LIV2/A4092-dev/README.md

# A4092

A modern successor to the A4091.

* TSSOP parts for smaller footprint
* Flash instead of EPROM
* CPLD instead of GALs
* Autoconfig moved into CPLD

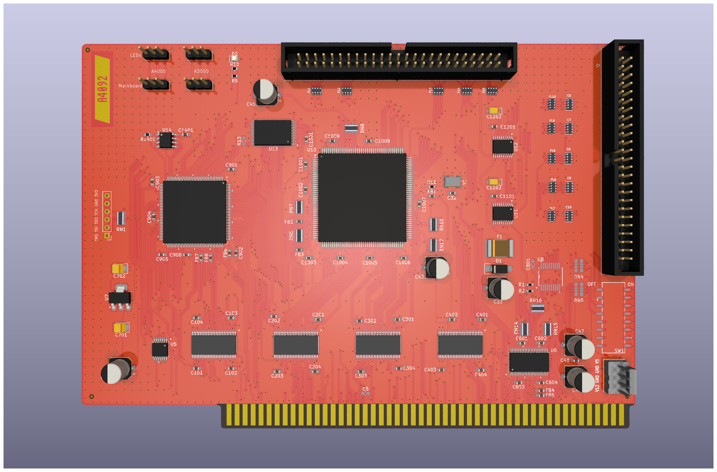
[picture p1: Docs/PCB.png]
PCB
