LIV2/A4092-dev/GALs/README.md

This is the old GAL based implementation of the A4091 glue logic for reference
