LIV2/A4092-dev/Kicad/Terminator-DS21S07/A4092-terminator-ds2107.kicad_pcb

## KiCad design Kicad/Terminator-DS21S07/A4092-terminator-ds2107.kicad_pcb (2025-06-09)

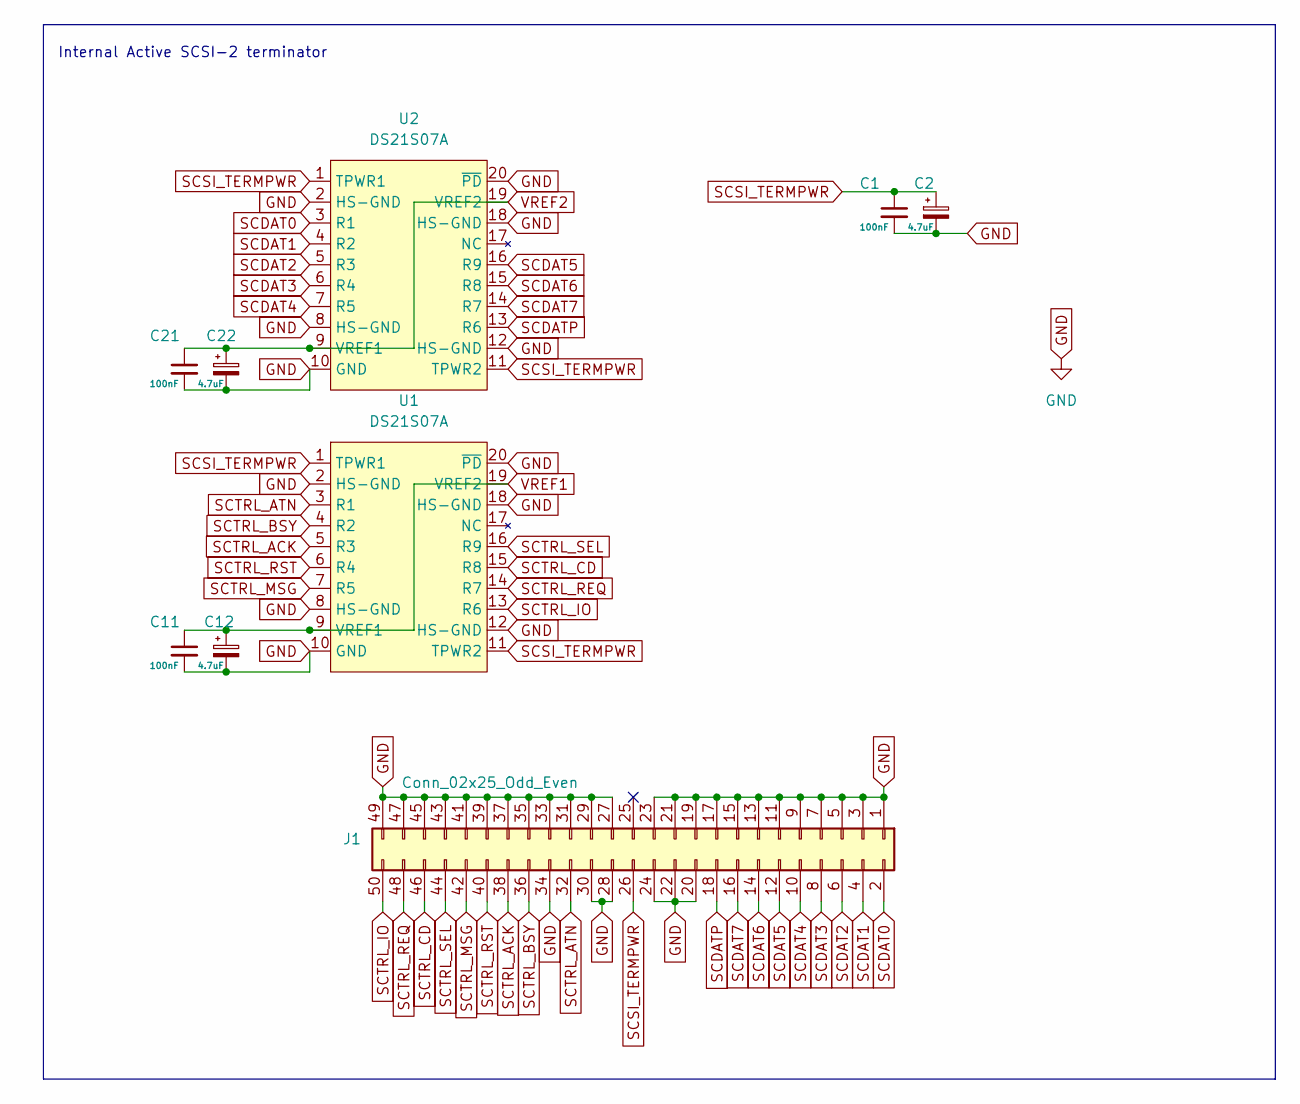
[picture p2: schematic A4092-terminator-ds2107.kicad_sch, A4092 backpanel PCB]

Parts:
C1, C11, C21: 100nF; C_0603_1608Metric_Pad1.08x0.95mm_HandSolder; LCSC Part # C14663
C2, C12, C22: 4.7uF; CP_EIA-3216-10_Kemet-I_HandSolder; LCSC Part # C7189
J1: Conn_02x25_Odd_Even; IDC-Header_2x25_P2.54mm_Horizontal; LCSC Part # C7430330
U1, U2: DS21S07A; TSSOP-20_4.4x6.5mm_P0.65mm; LCSC Part # C6602097

Connections:
GND: C1.2, C2.2, C11.2, C12.2, C21.2, C22.2, J1.1, J1.3, J1.5, J1.7, J1.9, J1.11, J1.13, J1.15, J1.17, J1.19, J1.20, J1.21, J1.22, J1.23, J1.24, J1.27, J1.28, J1.29, J1.30, J1.31, J1.33, J1.34, J1.35, J1.37, J1.39, J1.41, J1.43, J1.45, J1.47, J1.49, U1.2 (HS-GND), U1.8 (HS-GND), U1.10 (GND), U1.12 (HS-GND), U1.18 (HS-GND), U1.20 (~PD), U2.2 (HS-GND), U2.8 (HS-GND), U2.10 (GND), U2.12 (HS-GND), U2.18 (HS-GND), U2.20 (~PD)
SCDAT0: J1.2, U2.3 (R1)
SCDAT1: J1.4, U2.4 (R2)
SCDAT2: J1.6, U2.5 (R3)
SCDAT3: J1.8, U2.6 (R4)
SCDAT4: J1.10, U2.7 (R5)
SCDAT5: J1.12, U2.16 (R9)
SCDAT6: J1.14, U2.15 (R8)
SCDAT7: J1.16, U2.14 (R7)
SCDATP: J1.18, U2.13 (R6)
SCSI_TERMPWR: C1.1, C2.1, J1.26, U1.1 (TPWR1), U1.11 (TPWR2), U2.1 (TPWR1), U2.11 (TPWR2)
SCTRL_ACK: J1.38, U1.5 (R3)
SCTRL_ATN: J1.32, U1.3 (R1)
SCTRL_BSY: J1.36, U1.4 (R2)
SCTRL_CD: J1.46, U1.15 (R8)
SCTRL_IO: J1.50, U1.13 (R6)
SCTRL_MSG: J1.42, U1.7 (R5)
SCTRL_REQ: J1.48, U1.14 (R7)
SCTRL_RST: J1.40, U1.6 (R4)
SCTRL_SEL: J1.44, U1.16 (R9)
VREF1: C11.1, C12.1, U1.9 (VREF1), U1.19 (VREF2)
VREF2: C21.1, C22.1, U2.9 (VREF1), U2.19 (VREF2)

Notes on the sheet:
Internal Active SCSI-2 terminator

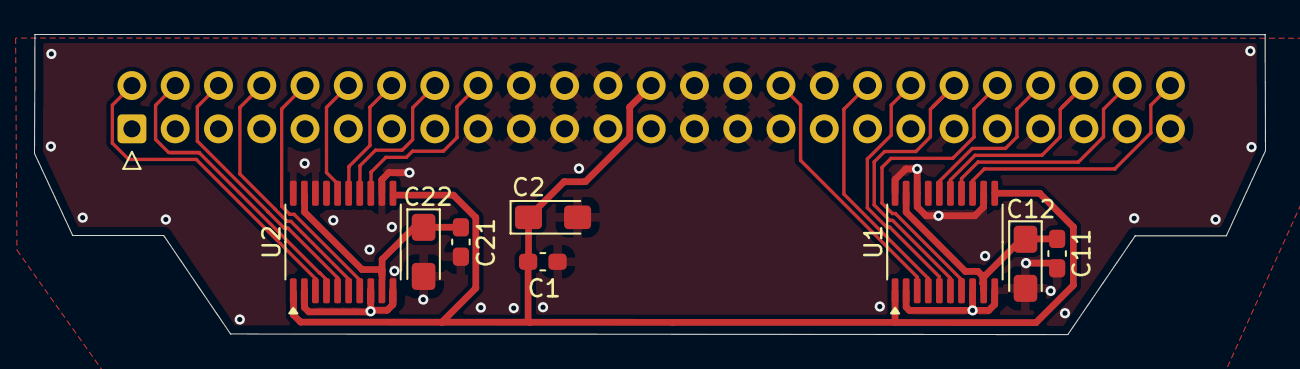
[picture p3: board A4092-terminator-ds2107.kicad_pcb from above]

Board: 2 copper layers, 72.3 x 17.6 mm, 9 parts (0 on the bottom side), 22 nets.
