LIV2/A4092-dev/Kicad/Terminator-dev/A4092-terminator-dev.kicad_pcb

## KiCad design Kicad/Terminator-dev/A4092-terminator-dev.kicad_pcb (2025-06-09)

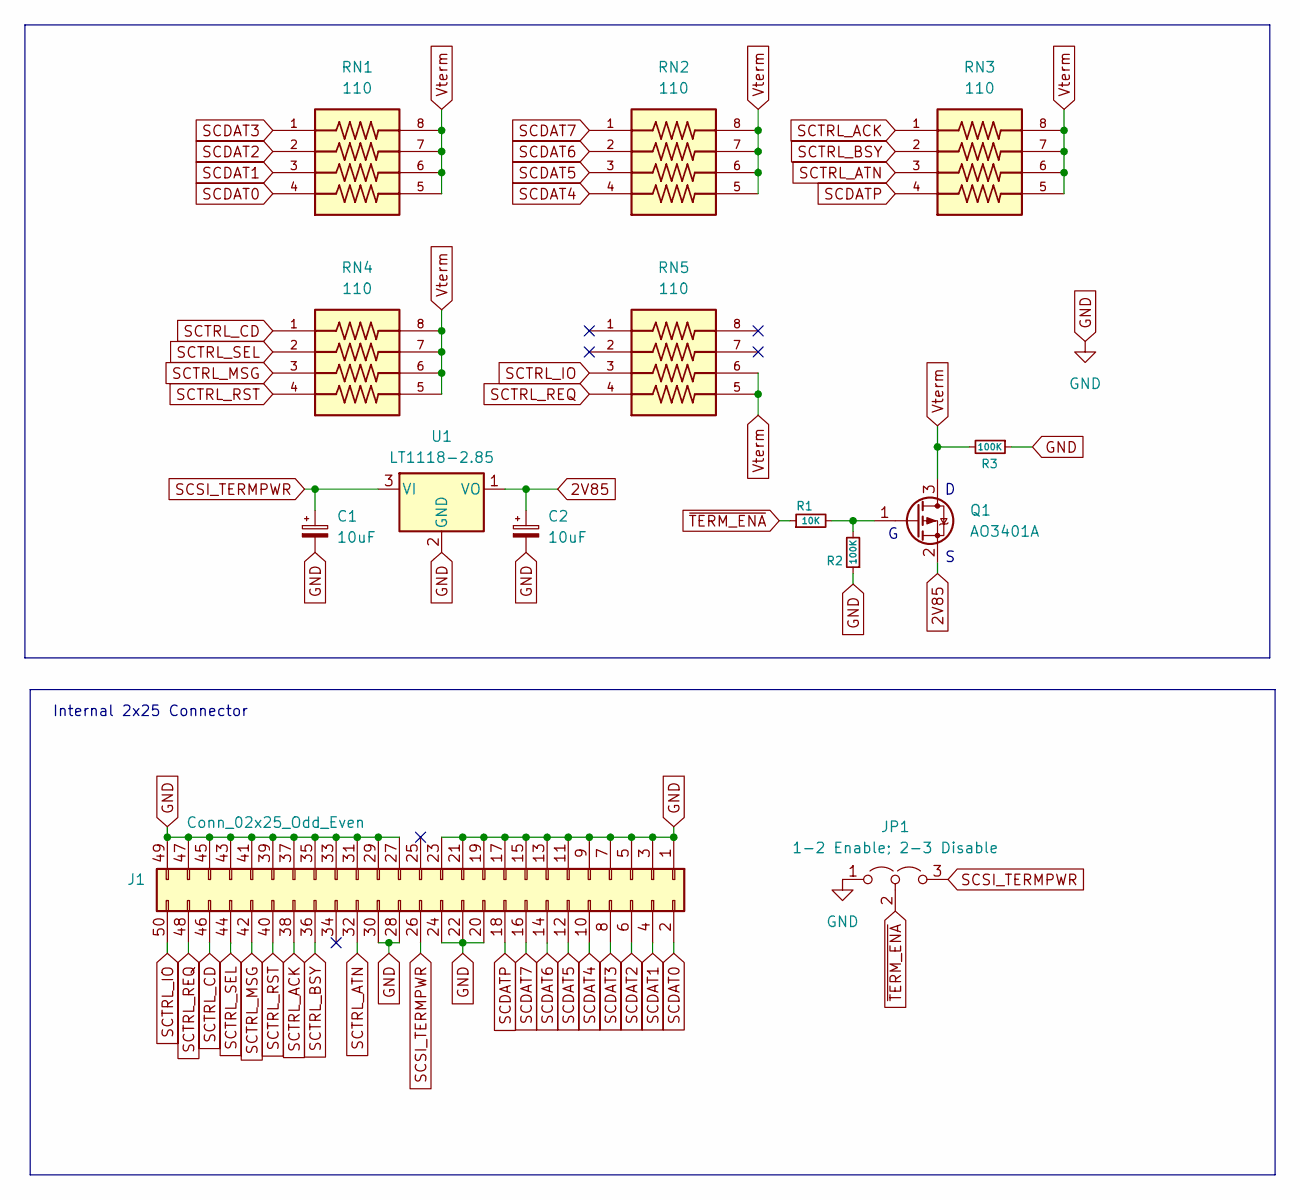
[picture p4: schematic A4092-terminator-dev.kicad_sch, A4092 backpanel PCB]

Parts:
C1, C2: 10uF; CP_EIA-2012-12_Kemet-R; LCSC Part # C7171
J1: Conn_02x25_Odd_Even; IDC-Header_2x25_P2.54mm_Horizontal; LCSC Part # C7430330
JP1: 1-2 Enable; 2-3 Disable; PinHeader_1x03_P2.00mm_Horizontal
Q1: AO3401A; SOT-23
R1: 10K; R_0603_1608Metric
R2, R3: 100K; R_0603_1608Metric
RN1, RN2, RN3, RN4, RN5: 110; BO_CAY16; PARTREV V.9; LCSC Part # C176176
U1: LT1118-2.85; SOT-223-3_TabPin2; LCSC Part # C2870974

Connections:
2V85: C2.1, Q1.2 (S), U1.1 (VO)
GND: C1.2, C2.2, J1.1, J1.3, J1.5, J1.7, J1.9, J1.11, J1.13, J1.15, J1.17, J1.19, J1.20, J1.21, J1.22, J1.23, J1.24, J1.27, J1.28, J1.29, J1.30, J1.31, J1.33, J1.35, J1.37, J1.39, J1.41, J1.43, J1.45, J1.47, J1.49, JP1.1 (A), R2.1, R3.1, U1.2 (GND)
unnamed: Q1.1 (G), R1.2, R2.2
SCDAT0: J1.2, RN1.4
SCDAT1: J1.4, RN1.3
SCDAT2: J1.6, RN1.2
SCDAT3: J1.8, RN1.1
SCDAT4: J1.10, RN2.4
SCDAT5: J1.12, RN2.3
SCDAT6: J1.14, RN2.2
SCDAT7: J1.16, RN2.1
SCDATP: J1.18, RN3.4
SCSI_TERMPWR: C1.1, J1.26, JP1.3 (B), U1.3 (VI)
SCTRL_ACK: J1.38, RN3.1
SCTRL_ATN: J1.32, RN3.3
SCTRL_BSY: J1.36, RN3.2
SCTRL_CD: J1.46, RN4.1
SCTRL_IO: J1.50, RN5.3
SCTRL_MSG: J1.42, RN4.3
SCTRL_REQ: J1.48, RN5.4
SCTRL_RST: J1.40, RN4.4
SCTRL_SEL: J1.44, RN4.2
Vterm: Q1.3 (D), R3.2, RN1.5, RN1.6, RN1.7, RN1.8, RN2.5, RN2.6, RN2.7, RN2.8, RN3.5, RN3.6, RN3.7, RN3.8, RN4.5, RN4.6, RN4.7, RN4.8, RN5.5, RN5.6
~TERM_ENA: JP1.2 (C), R1.1

Notes on the sheet:
Internal 2x25 Connector

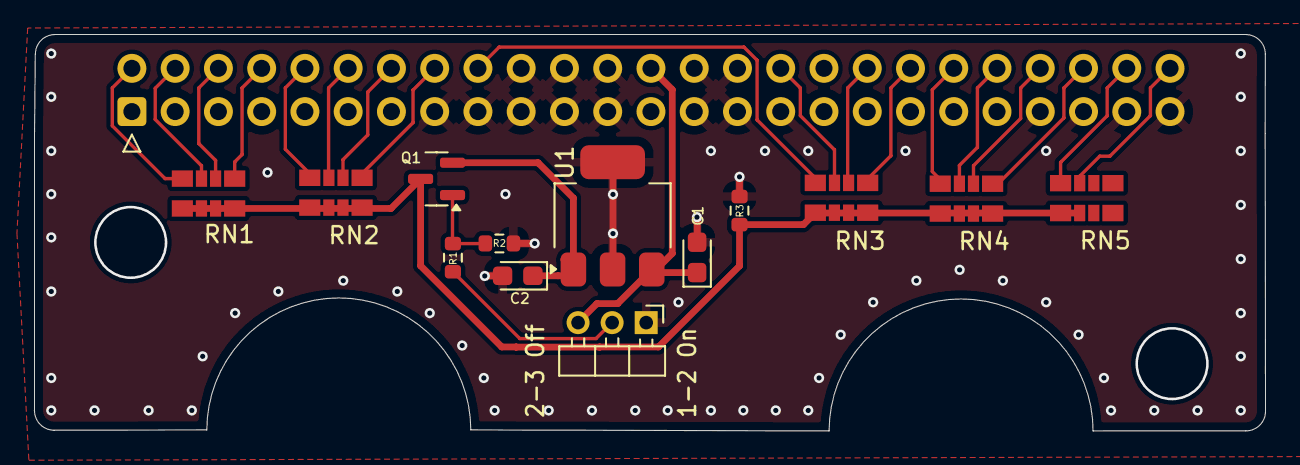
[picture p5: board A4092-terminator-dev.kicad_pcb from above]

Board: 2 copper layers, 72.3 x 23.3 mm, 14 parts (0 on the bottom side), 24 nets.
