LIV2/A4092-dev/Kicad/A4092.kicad_pcb

## KiCad design Kicad/A4092.kicad_pcb (2025-05-24)

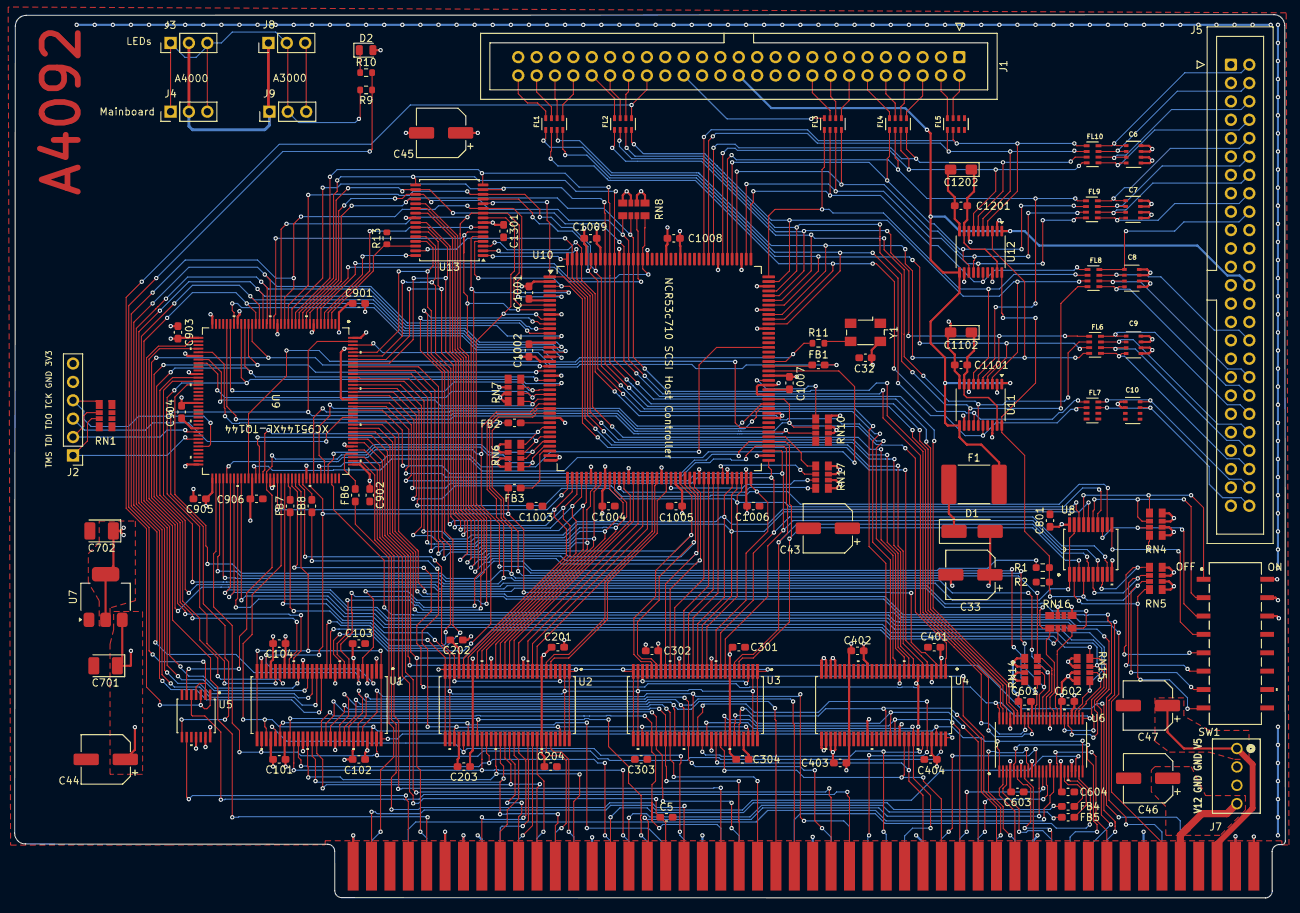
[picture p6: board A4092.kicad_pcb from above]

Board: 4 copper layers, 175.6 x 122.1 mm, 118 parts (0 on the bottom side), 260 nets.

Parts:
C5: 10pF; C_0603_1608Metric_Pad1.08x0.95mm_HandSolder
C6, C7, C8, C9, C10: 100pF; CAP_CA0612_3P2X1P6_YAG
C32, C1002, C1004, C1006, C1008: 10nF; C_0603_1608Metric_Pad1.08x0.95mm_HandSolder
C33, C43, C44, C45, C46, C47: 47uF; CP_Elec_6.3x7.7
C101, C102, C103, C104, C201, C202, C203, C204, C301, C302, C303, C304, C401, C402, C403, C404, C601, C602, C603, C604, C801, C901, C902, C903, C904, C905, C906, C1001, C1003, C1005, C1007, C1009, C1101, C1201, C1301: 100nF; C_0603_1608Metric_Pad1.08x0.95mm_HandSolder
C701: 10uF; CP_EIA-3528-15_AVX-H_HandSolder
C702: 22uF; CP_EIA-3528-15_AVX-H_HandSolder
C1102, C1202: 4.7uF; CP_EIA-3216-10_Kemet-I_HandSolder
CN1: Zorro3; Zorro3-CardEdge
D1: SS24; D_SMA_Handsoldering
D2: LED (green); LED_0805_2012Metric
F1: ASMDC185F/33-2; Fuse_2920_7451Metric_Pad2.10x5.45mm_HandSolder
FB1, FB2, FB3, FB4, FB5, FB6, FB7, FB8: 60; C_0603_1608Metric_Pad1.08x0.95mm_HandSolder
FL1, FL2, FL3, FL4, FL5, FL6, FL7, FL8, FL9, FL10: DA1206D600R-10; FB_DA1206D600R-10
J1, J5: Conn_02x25_Odd_Even; IDC-Header_2x25_P2.54mm_Vertical
J2: Conn_01x06_Pin; PinHeader_1x06_P2.54mm_Vertical
J3: TO-LED; PinHeader_1x03_P2.54mm_Vertical
J4: TO-MB; PinHeader_1x03_P2.54mm_Vertical
J7: 22112042; CONN_A-6373-04A_MOL
J8: TO-A3000-LED; PinHeader_1x03_P2.54mm_Vertical
J9: TO-A3000-MB; PinHeader_1x03_P2.54mm_Vertical
R1: 0; R_0603_1608Metric_Pad0.98x0.95mm_HandSolder
R2: 4K7; R_0603_1608Metric_Pad0.98x0.95mm_HandSolder
R9, R11: 120; R_0603_1608Metric
R10: 2.2k; R_0603_1608Metric
R13: 1K; R_0603_1608Metric
RN1: 4.7K; BO_CAY16
RN4, RN5, RN6, RN7, RN8, RN10, RN14, RN15, RN16, RN17: 1K; BO_CAY16
SW1: 219-8MST; SO16_219-8_CTS
U1, U2, U3, U4: SN74ABT16543DGGR; DL56
U5: 74LVC07APW_118; TSSOP14_5P1X4P5_NEX
U6: SN74ABT16245ADGGR; DGG48
U7: AMS1117-3.3; SOT-223-3_TabPin2
U8: SN74F244DB; DB20
U9: XC95144XL-TQ144; 144-TQFP_XIL
U10: NCR53c710 SCSI Host Controller; PQFP-160_28x28mm_P0.65mm
U11, U12: DS21S07A; TSSOP-20_4.4x6.5mm_P0.65mm
U13: SST39SF010/020/040; TSSOP-32_8x11mm_P0.65mm
Y1: Abracon ACO-50MHz; Oscillator_SMD_Fox_FT5H_5.0x3.2mm

Connections:
A0: RN8.4, U9.6 (I/O/GTS2), U10.144 (A0)
A1: RN8.3, U9.7, U10.145 (A1)
A2: RN8.2, U6.40 (1A6), U9.9, U10.146 (A2), U13.20 (A0)
A3: RN8.1, U6.41 (1A5), U9.10, U10.147 (A3), U13.19 (A1)
A4: U6.43 (1A4), U9.11, U10.148 (A4), U13.18 (A2)
A5: U6.44 (1A3), U9.12, U10.150 (A5), U13.17 (A3)
A6: U6.46 (1A2), U9.13, U10.151 (A6), U13.16 (A4)
A7: U6.47 (1A1), U9.14, U10.152 (A7), U13.15 (A5)
A8: U4.14 (1A8), U9.15, U10.154 (A8), U13.14 (A6)
A9: U4.13 (1A7), U10.155 (A9), U13.13 (A7)
A10: U4.12 (1A6), U10.157 (A10), U13.3 (A8)
A11: U4.10 (1A5), U10.158 (A11), U13.2 (A9)
A12: U4.9 (1A4), U10.159 (A12), U13.31 (A10)
A13: U4.8 (1A3), U10.160 (A13), U13.1 (A11)
A14: U4.6 (1A2), U10.1 (A14), U13.12 (A12)
A15: U4.5 (1A1), U10.3 (A15), U13.4 (A13)
A16: U1.5 (1A1), U10.4 (A16), U13.5 (A14)
A17: U1.6 (1A2), U9.16, U10.5 (A17), U13.11 (A15)
A18: U1.8 (1A3), U9.17, U10.7 (A18), U13.10 (A16)
A19: U1.9 (1A4), U9.19, U10.8 (A19), U13.6 (NC/A17)
A20: U1.10 (1A5), U10.10 (A20), U13.9 (NC/A18)
A21: U1.12 (1A6), U10.11 (A21)
A22: U1.13 (1A7), U10.12 (A22)
A23: U1.14 (1A8), U9.20, U10.13 (A23)
A24: U1.15 (2A1), U9.21, U10.14 (A24)
A25: U1.16 (2A2), U9.22, U10.16 (A25)
A26: U1.17 (2A3), U9.23, U10.17 (A26)
A27: U1.19 (2A4), U9.24, U10.18 (A27)
A28: U1.20 (2A5), U9.25, U10.20 (A28)
A29: U1.21 (2A6), U9.26, U10.21 (A29)
A30: U1.23 (2A7), U9.27, U10.23 (A30)
A31: U1.24 (2A8), U9.28, U10.24 (A31)
ABOEH: U1.1 (*1OEAB), U1.28 (*2OEAB), U1.29 (*2OEBA), U1.56 (*1OEBA), U4.56 (*1OEBA), U9.96
ABOEL: U6.25 (*2OE), U6.48 (*1OE), U9.95
BERR: RN6.1, U5.6 (3Y), U9.88, U10.37 (~BERR/~TEA)
BGACK: RN10.1, U10.98 (~BGACK/~BB)
BMASTER: U1.31 (*2CEBA), U1.54 (*1CEBA), U4.54 (*1CEBA), U6.1 (1DIR), U6.24 (2DIR), U9.92
CBACK: RN6.3, U9.86, U10.35 (~CBACK/~TBI)
CBREQ: RN6.4, U9.87, U10.33 (~CBREQ/~TT1)
CLK: U9.91, U10.41 (BCLK)
CLK_50M: R11.2, U9.30 (I/O/GCK1), U10.102 (SCLK)
D0: U3.5 (1A1), U8.3 (2Y4), U9.124, U10.85 (D0)
D1: U3.6 (1A2), U8.5 (2Y3), U9.125, U10.84 (D1)
D2: U3.8 (1A3), U8.7 (2Y2), U9.126, U10.83 (D2)
D2Z: U2.3 (*1CEAB), U2.26 (*2CEAB), U3.3 (*1CEAB), U3.26 (*2CEAB), U9.97
D3: U3.9 (1A4), U8.9 (2Y1), U9.128, U10.81 (D3)
D4: U3.10 (1A5), U8.12 (1Y4), U9.129, U10.80 (D4)
D5: U3.12 (1A6), U8.14 (1Y3), U9.130, U10.78 (D5)
D6: U3.13 (1A7), U8.16 (1Y2), U9.131, U10.77 (D6)
D7: U3.14 (1A8), U8.18 (1Y1), U9.132, U10.76 (D7)
D8: U3.15 (2A1), U10.73 (D8)
D9: U3.16 (2A2), U10.72 (D9)
D10: U3.17 (2A3), U10.71 (D10)
D11: U3.19 (2A4), U10.70 (D11)
D12: U3.20 (2A5), U10.68 (D12), U13.21 (D0)
D13: U3.21 (2A6), U10.67 (D13), U13.22 (D1)
D14: U3.23 (2A7), U10.66 (D14), U13.23 (D2)
D15: U3.24 (2A8), U10.65 (D15), U13.25 (D3)
D16: U2.5 (1A1), U10.62 (D16)
D17: U2.6 (1A2), U10.60 (D17)
D18: U2.8 (1A3), U10.59 (D18)
D19: U2.9 (1A4), U10.58 (D19)
D20: U2.10 (1A5), U10.57 (D20)
D21: U2.12 (1A6), U10.56 (D21)
D22: U2.13 (1A7), U10.55 (D22)
D23: U2.14 (1A8), U10.53 (D23)
D24: U2.15 (2A1), U9.133, U10.51 (D24)
D25: U2.16 (2A2), U9.134, U10.50 (D25)
D26: U2.17 (2A3), U9.135, U10.48 (D26)
D27: U2.19 (2A4), U9.136, U10.47 (D27)
D28: U2.20 (2A5), U9.137, U10.45 (D28), U13.26 (D4)
D29: U2.21 (2A6), U9.138, U10.44 (D29), U13.27 (D5)
D30: U2.23 (2A7), U9.139, U10.43 (D30), U13.28 (D6)
D31: U2.24 (2A8), U9.140, U10.42 (D31), U13.29 (D7)
DBLT: U2.2 (*1LEAB), U2.27 (*2LEAB), U2.30 (*2LEBA), U2.55 (*1LEBA), U3.2 (*1LEAB), U3.27 (*2LEAB), U3.30 (*2LEBA), U3.55 (*1LEBA), U9.93
DBOE: FB7.1, U2.1 (*1OEAB), U2.28 (*2OEAB), U2.29 (*2OEBA), U2.56 (*1OEBA), U3.1 (*1OEAB), U3.28 (*2OEAB), U3.29 (*2OEBA), U3.56 (*1OEBA)
DIP_EXT_TERM: R1.1, R2.1, RN5.3, SW1.7, U8.4 (1A2), U11.20 (~PD), U12.20 (~PD)
DIP_LONG_SPINUP: RN5.1, SW1.5, U8.8 (1A4)
DIP_SCSI_ADDR0: RN4.1, SW1.1, U8.17 (2A4)
DIP_SCSI_ADDR1: RN4.2, SW1.2, U8.15 (2A3)
DIP_SCSI_ADDR2: RN4.3, SW1.3, U8.13 (2A2)
DIP_SCSI_FAST: RN4.4, SW1.4, U8.11 (2A1)
DIP_SCSI_LUNS: RN5.4, SW1.8, U8.2 (1A1)
DIP_SYNCH_MODE: RN5.2, SW1.6, U8.6 (1A3)
DP0: RN17.1, U10.86 (DP0)
DP1: RN17.2, U10.74 (DP1)
DP2: RN17.3, U10.63 (DP2)
DP3_ABRT: RN17.4, U10.52 (DP3/~ABRT)
GND: C5.2, C6.5, C6.6, C6.7, C6.8, C7.5, C7.6, C7.7, C7.8, C8.5, C8.6, C8.7, C8.8, C9.5, C9.6, C9.7, C9.8, C10.5, C10.6, C32.1, C33.2, C43.2, C44.2, C45.2, C46.2, C47.2, C101.2, C102.2, C103.2, C104.2, C201.2, C202.2, C203.2, C204.2, C301.2, C302.2, C303.2, C304.2, C401.2, C402.2, C403.2, C404.2, C601.2, C602.2, C603.2, C604.2, C701.2, C702.2, C801.2, C901.2, C902.2, C903.2, C904.2, C905.2, C906.2, C1001.2, C1002.2, C1003.2, C1004.2, C1005.2, C1006.2, C1007.2, C1008.2, C1009.2, C1101.2, C1102.2, C1201.2, C1202.2, C1301.2, CN1.1 (GND), CN1.2 (GND), CN1.3 (GND), CN1.4 (GND), CN1.13 (GND), CN1.25 (GND), CN1.37 (GND), CN1.49 (GND), CN1.61 (GND), CN1.73 (GND), CN1.85 (GND), CN1.87 (GND), CN1.88 (GND), CN1.89 (GND), CN1.90 (GND), CN1.99 (GND), CN1.100 (GND), J1.1, J1.3, J1.5, J1.7, J1.9, J1.11, J1.13, J1.15, J1.17, J1.19, J1.20, J1.21, J1.22, J1.23, J1.24, J1.27, J1.28, J1.29, J1.30, J1.31, J1.33, J1.35, J1.37, J1.39, J1.41, J1.43, J1.45, J1.47, J1.49, J2.5, J5.1, J5.3, J5.5, J5.7, J5.9, J5.11, J5.13, J5.15, J5.17, J5.19, J5.20, J5.21, J5.22, J5.23, J5.24, J5.27, J5.28, J5.29, J5.30, J5.31, J5.33, J5.35, J5.37, J5.39, J5.41, J5.43, J5.45, J5.47, J5.49, J7.2, J7.3, R13.2, RN16.8, SW1.9, SW1.10, SW1.11, SW1.12, SW1.13, SW1.14, SW1.15, SW1.16, U1.2 (*1LEAB), U1.4 (GND), U1.11 (GND), U1.18 (GND), U1.25 (GND), U1.27 (*2LEAB), U1.32 (GND), U1.39 (GND), U1.46 (GND), U1.53 (GND), U2.4 (GND), U2.11 (GND), U2.18 (GND), U2.25 (GND), U2.32 (GND), U2.39 (GND), U2.46 (GND), U2.53 (GND), U3.4 (GND), U3.11 (GND), U3.18 (GND), U3.25 (GND), U3.32 (GND), U3.39 (GND), U3.46 (GND), U3.53 (GND), U4.2 (*1LEAB), U4.4 (GND), U4.11 (GND), U4.18 (GND), U4.25 (GND), U4.26 (*2CEAB), U4.27 (*2LEAB), U4.28 (*2OEAB), U4.29 (*2OEBA), U4.30 (*2LEBA), U4.31 (*2CEBA), U4.32 (GND), U4.39 (GND), U4.46 (GND), U4.53 (GND), U5.7 (GND), U5.11 (5A), U5.13 (6A), U6.4 (GND), U6.10 (GND), U6.15 (GND), U6.21 (GND), U6.28 (GND), U6.34 (GND), U6.39 (GND), U6.45 (GND), U7.1 (GND), U8.10 (GND), U9.18 (GND), U9.29 (GND), U9.36 (GND), U9.47 (GND), U9.62 (GND), U9.72 (GND), U9.89 (GND), U9.90 (GND), U9.99 (GND), U9.108 (GND), U9.114 (GND), U9.123 (GND), U9.144 (GND), U10.2 (V_{SS}), U10.9 (V_{SS}), U10.15 (V_{SS}), U10.22 (V_{SS}), U10.31 (V_{SS}), U10.46 (V_{SS}), U10.54 (V_{SS}), U10.61 (V_{SS}), U10.69 (V_{SS}), U10.75 (V_{SS}), U10.82 (V_{SS}), U10.96 (V_{SS}), U10.109 (V_{SS}), U10.113 (V_{SS}), U10.118 (V_{SS}), U10.123 (V_{SS}), U10.128 (V_{SS}), U10.136 (V_{SS}), U10.143 (V_{SS}), U10.149 (V_{SS}), U10.156 (V_{SS}), U11.2 (HS-GND), U11.8 (HS-GND), U11.10 (GND), U11.12 (HS-GND), U11.18 (HS-GND), U12.2 (HS-GND), U12.8 (HS-GND), U12.10 (GND), U12.12 (HS-GND), U12.18 (HS-GND), U13.24 (GND), Y1.2 (GND)
IORST: RN10.2, U4.1 (*1OEAB), U5.8 (4Y), U9.143 (I/O/GSR), U10.94 (~RESET)
LED: R9.1, R10.2, U5.2 (1Y), U5.4 (2Y)
LED3KPWR: J8.3, J9.3
LEDR: J3.1, J3.3, J4.1, J4.3, J8.2, J9.2, R9.2
MASTER: FB3.2, U1.3 (*1CEAB), U1.26 (*2CEAB), U4.3 (*1CEAB), U9.100
NCR_INT: U9.103, U10.105 (~IRQ0)
unnamed: D1.1 (K), F1.1
unnamed: D2.1 (K), R10.1
unnamed: FL5.7, J1.2
unnamed: FL5.8, J1.4
unnamed: FL4.5, J1.6
unnamed: FL4.6, J1.8
unnamed: FL4.7, J1.10
unnamed: FL4.8, J1.12
unnamed: FL3.5, J1.14
unnamed: FL3.6, J1.16
unnamed: FL3.7, J1.18
unnamed: FL3.8, J1.32
unnamed: FL2.6, J1.38
unnamed: FL2.7, J1.40
unnamed: FL2.8, J1.42
unnamed: FL1.5, J1.44
unnamed: FL1.6, J1.46
unnamed: FL1.7, J1.48
unnamed: FL1.8, J1.50
unnamed: C6.1, FL10.8, J5.2
unnamed: C6.2, FL10.7, J5.4
unnamed: C6.3, FL10.6, J5.6
unnamed: C6.4, FL10.5, J5.8
unnamed: C7.1, FL9.8, J5.10
unnamed: C7.2, FL9.7, J5.12
unnamed: C7.3, FL9.6, J5.14
unnamed: C7.4, FL9.5, J5.16
unnamed: C8.1, FL8.8, J5.18
unnamed: C8.2, FL8.7, J5.32
unnamed: C8.3, FL8.6, J5.36
unnamed: C8.4, FL8.5, J5.38
unnamed: C9.1, FL6.8, J5.40
unnamed: C9.2, FL6.7, J5.42
unnamed: C9.3, FL6.6, J5.44
unnamed: C9.4, FL6.5, J5.46
unnamed: C10.4, FL7.8, J5.48
unnamed: C10.3, FL7.7, J5.50
unnamed: FB4.1, U6.19 (2B5)
unnamed: FB5.1, U6.20 (2B6)
unnamed: FB7.2, U9.94
unnamed: FB8.2, U9.98
unnamed: FB6.2, U9.112
unnamed: FB2.1, U10.32 (R_W)
unnamed: FB1.1, U10.101 (~BR)
unnamed: FB3.1, U10.38 (~MASTER)
unnamed: C1101.1, C1102.1, U11.9 (VREF1), U11.19 (VREF2)
unnamed: C1201.1, C1202.1, U12.9 (VREF1), U12.19 (VREF2)
unnamed: R11.1, Y1.3 (OUT)
PLD_AS: RN7.3, U9.31, U10.25 (~AS/~TS)
PLD_DOE: RN16.1, U6.33 (2A3), U9.40
PLD_DS: RN10.3, U9.32 (I/O/GCK2), U10.87 (~DS/DLE)
PLD_DS0: RN15.2, U6.26 (2A8), U9.78
PLD_DS1: RN15.1, U6.27 (2A7), U9.79
PLD_DS2: RN15.4, U6.29 (2A6), U9.80
PLD_DS3: RN15.3, U6.30 (2A5), U9.81
PLD_EXT_TERM: R1.2, U9.50
PLD_FC0: RN14.4, U6.35 (2A2), U9.75, U10.30 (FCS0/TM0)
PLD_FC1: RN14.3, U6.36 (2A1), U9.76, U10.29 (FCS1/TM1)
PLD_FC2: RN14.1, U6.38 (1A7), U9.77, U10.28 (FCS2/TM2)
PLD_FCS: U1.30 (*2LEBA), U1.55 (*1LEBA), U4.55 (*1LEBA), U9.74
PLD_MTCR: RN16.4, U6.32 (2A4), U9.48
PLD_READ: FB2.2, RN14.2, U6.37 (1A8), U9.41
PLD_SID: U8.1 (*1OE), U8.19 (*2OE), U9.49
PLD_SIZ0: RN7.1, U9.43, U10.27 (SIZ0)
PLD_SIZ1: RN7.2, U9.44, U10.26 (SIZ1)
ROM_CE: R13.1, U9.3 (I/O/GTS4), U13.30 (CE)
ROM_OE: U9.5 (I/O/GTS1), U13.32 (OE)
ROM_WE: U9.4, U13.7 (PGM)
SBG: U9.85, U10.100 (~BG)
SBR: FB1.2, U9.83
SC0: U9.142, U10.88 (SC0)
SCDAT0: FL5.2, FL10.1, U10.131 (~SD0), U12.4 (R2)
SCDAT1: FL5.1, FL10.2, U10.130 (~SD1), U12.5 (R3)
SCDAT2: FL4.4, FL10.3, U10.129 (~SD2), U12.6 (R4)
SCDAT3: FL4.3, FL10.4, U10.127 (~SD3), U12.7 (R5)
SCDAT4: FL4.2, FL9.1, U10.126 (~SD4), U11.6 (R4)
SCDAT5: FL4.1, FL9.2, U10.125 (~SD5), U12.13 (R6)
SCDAT6: FL3.4, FL9.3, U10.124 (~SD6), U12.14 (R7)
SCDAT7: FL3.3, FL9.4, U10.122 (~SD7), U12.15 (R8)
SCDATP: FL3.2, FL8.1, U10.121 (~SDP), U12.16 (R9)
SCSI_BUSY: FL2.5, J1.36, U5.1 (1A), U5.3 (2A)
SCSI_TERMPWR: F1.2, J1.26, J5.26, U11.1 (TPWR1), U11.11 (TPWR2), U12.1 (TPWR1), U12.11 (TPWR2)
SCTRL_ACK: FL2.3, FL8.4, U10.117 (~ACK), U11.13 (R6)
SCTRL_ATN: FL3.1, FL8.2, U10.120 (~ATN), U11.7 (R5)
SCTRL_BSY: FL2.4, FL8.3, U10.119 (~BSY), U11.3 (R1)
SCTRL_CD: FL1.3, FL6.4, U10.112 (C/D), U12.3 (R1)
SCTRL_IO: FL1.1, FL7.2, U10.110 (I/O), U11.16 (R9)
SCTRL_MSG: FL2.1, FL6.2, U10.115 (~MSG), U11.15 (R8)
SCTRL_REQ: FL1.2, FL7.1, U10.111 (~REQ), U11.14 (R7)
SCTRL_RST: FL2.2, FL6.1, U10.116 (~RST), U11.5 (R3)
SCTRL_SEL: FL1.4, FL6.3, U10.114 (~SEL), U11.4 (R2)
SLACK: U9.101, U10.92 (~SLACK)
SREG: U9.104, U10.93 (~CS)
STERM: RN6.2, U9.105, U10.36 (STERM/~TA)
TCK: J2.4, RN1.1, U9.67 (TCK)
TDI: J2.2, RN1.2, U9.63 (TDI)
TDO: J2.3, U9.122 (TDO)
TMS: J2.1, RN1.3, U9.65 (TMS)
V3_3: C702.1, C901.1, C902.1, C903.1, C904.1, C905.1, C906.1, J2.6, RN1.6, RN1.7, RN1.8, U7.2 (VO), U9.1 (VCCIO), U9.8 (VCCINT), U9.37 (VCCIO), U9.42 (VCCINT), U9.55 (VCCIO), U9.73 (VCCIO), U9.84 (VCCINT), U9.109 (VCCIO), U9.127 (VCCIO), U9.141 (VCCINT)
V5: C32.2, C33.1, C43.1, C44.1, C45.1, C47.1, C101.1, C102.1, C103.1, C104.1, C201.1, C202.1, C203.1, C204.1, C301.1, C302.1, C303.1, C304.1, C401.1, C402.1, C403.1, C404.1, C601.1, C602.1, C603.1, C604.1, C701.1, C801.1, C1001.1, C1002.1, C1003.1, C1004.1, C1005.1, C1006.1, C1007.1, C1008.1, C1009.1, C1301.1, CN1.5 (+5), CN1.6 (+5), D1.2 (A), D2.2 (A), J3.2, J4.2, J7.1, J8.1, J9.1, R2.2, RN4.5, RN4.6, RN4.7, RN4.8, RN5.5, RN5.6, RN5.7, RN5.8, RN6.5, RN6.6, RN6.7, RN6.8, RN7.6, RN7.7, RN7.8, RN8.5, RN8.6, RN8.7, RN8.8, RN10.6, RN10.7, RN10.8, RN14.5, RN14.6, RN14.7, RN14.8, RN15.5, RN15.6, RN15.7, RN15.8, RN16.5, RN16.7, RN17.5, RN17.6, RN17.7, RN17.8, U1.7 (VCC), U1.22 (VCC), U1.35 (VCC), U1.50 (VCC), U2.7 (VCC), U2.22 (VCC), U2.35 (VCC), U2.50 (VCC), U3.7 (VCC), U3.22 (VCC), U3.35 (VCC), U3.50 (VCC), U4.7 (VCC), U4.22 (VCC), U4.35 (VCC), U4.50 (VCC), U5.14 (VCC), U6.7 (VCC), U6.18 (VCC), U6.31 (VCC), U6.42 (VCC), U7.3 (VI), U8.20 (VCC), U10.6 (V_{DD}), U10.19 (V_{DD}), U10.39 (V_{DD}), U10.40 (~HALT/~TIP), U10.49 (V_{DD}), U10.64 (V_{DD}), U10.79 (V_{DD}), U10.90 (~BIG_LIT), U10.91 (BS), U10.95 (~BOFF), U10.97 (~FETCH), U10.99 (V_{DD}), U10.139 (V_{DD}), U10.153 (V_{DD}), U13.8 (VCC), Y1.4 (VDD)
V12: C46.1, CN1.10 (+12), J7.4
Z2D: FB8.1, U2.31 (*2CEBA), U2.54 (*1CEBA), U3.31 (*2CEBA), U3.54 (*1CEBA)
Z_7M: CN1.92 (7Mhz), U9.38 (I/O/GCK3)
Z_A2: CN1.27 (A2), U6.9 (1B6)
Z_A3: CN1.26 (A3), U6.8 (1B5)
Z_A4: CN1.24 (A4), U6.6 (1B4)
Z_A5: CN1.21 (A5), U6.5 (1B3)
Z_A6: CN1.23 (A6), U6.3 (1B2)
Z_A7: CN1.28 (A7), U6.2 (1B1)
Z_A8D0: CN1.30 (A8/A8+D0), U3.52 (1B1), U4.43 (1B8)
Z_A9D1: CN1.32 (A9/A9+D1), U3.51 (1B2), U4.44 (1B7)
Z_A10D2: CN1.34 (A10/A10+D2), U3.49 (1B3), U4.45 (1B6)
Z_A11D3: CN1.36 (A11/A11+D3), U3.48 (1B4), U4.47 (1B5)
Z_A12D4: CN1.38 (A12/A12+D4), U3.47 (1B5), U4.48 (1B4)
Z_A13D5: CN1.39 (A13/A13+D5), U3.45 (1B6), U4.49 (1B3)
Z_A14D6: CN1.41 (A14/A14+D6), U3.44 (1B7), U4.51 (1B2)
Z_A15D7: CN1.43 (A15/A15+D7), U3.43 (1B8), U4.52 (1B1)
Z_A16D8: CN1.45 (A16/A16+D8), U1.52 (1B1), U3.42 (2B1)
Z_A17D9: CN1.47 (A17/A17+D9), U1.51 (1B2), U3.41 (2B2)
Z_A18D10: CN1.52 (A18/A18+D10), U1.49 (1B3), U3.40 (2B3)
Z_A19D11: CN1.54 (A19/A19+D11), U1.48 (1B4), U3.38 (2B4)
Z_A20D12: CN1.56 (A20/A20+D12), U1.47 (1B5), U3.37 (2B5)
Z_A21D13: CN1.58 (A21/A21+D13), U1.45 (1B6), U3.36 (2B6)
Z_A22D14: CN1.57 (A22/A22+D14), U1.44 (1B7), U3.34 (2B7)
Z_A23D15: CN1.59 (A23/A23+D15), U1.43 (1B8), U3.33 (2B8)
Z_A24D24: CN1.80 (D8/A24+D24), U1.42 (2B1), U2.42 (2B1)
Z_A25D25: CN1.78 (D9/A25+D25), U1.41 (2B2), U2.41 (2B2)
Z_A26D26: CN1.76 (D10/A26+D26), U1.40 (2B3), U2.40 (2B3)
Z_A27D27: CN1.71 (D11/A27+D27), U1.38 (2B4), U2.38 (2B4)
Z_A28D28: CN1.69 (D12/A28+D28), U1.37 (2B5), U2.37 (2B5)
Z_A29D29: CN1.67 (D13/A29+D29), U1.36 (2B6), U2.36 (2B6)
Z_A30D30: CN1.65 (D14/A30+D30), U1.34 (2B7), U2.34 (2B7)
Z_A31D31: CN1.63 (D15/A31+D31), U1.33 (2B8), U2.33 (2B8)
Z_BERR: CN1.46 (~BEER), U5.5 (3A)
Z_BGn: CN1.64 (~BGn), U9.110
Z_BRn: CN1.60 (~BRn), U9.111
Z_CFGIN: CN1.12 (~CFGIN), U9.119
Z_CFGOUT: CN1.11 (~CFGOUT), U9.120
Z_CINH: CN1.17 (~CINH/~OVR), U9.117
Z_D16: CN1.75 (D0/RSVD+D16), U2.52 (1B1)
Z_D17: CN1.77 (D1/RSVD+D17), U2.51 (1B2)
Z_D18: CN1.79 (D2/RSVD+D18), U2.49 (1B3)
Z_D19: CN1.81 (D3/RSVD+D19), U2.48 (1B4)
Z_D20: CN1.83 (D4/RSVD+D20), U2.47 (1B5)
Z_D21: CN1.86 (D5/RSVD+D21), U2.45 (1B6)
Z_D22: CN1.84 (D6/RSVD+D22), U2.44 (1B7)
Z_D23: CN1.82 (D7/RSVD+D23), U2.43 (1B8)
Z_DOE: CN1.93 (DOE), U6.16 (2B3)
Z_DS0: CN1.51 (~DS0/~VMA), U6.23 (2B8)
Z_DS1: CN1.98 (NC/~DS1), U6.22 (2B7)
Z_DS2: CN1.70 (~LDS/~DS2), FB5.2
Z_DS3: CN1.72 (~UDS/~DS3), FB4.2
Z_DTACK: C5.1, CN1.66 (~DTACK), U9.115
Z_FC0: CN1.31 (FC0), U6.14 (2B2)
Z_FC1: CN1.33 (FC1), U6.13 (2B1)
Z_FC2: CN1.35 (FC2), U6.11 (1B7)
Z_FCS: CN1.97 (NC/~FCS), FB6.1
Z_INT2: CN1.19 (~INT2), U9.106
Z_IORST: CN1.94 (~BUSRST/~IORST), U5.9 (4A)
Z_LOCK: CN1.29 (~LOCK/A1), U9.113
Z_MTACK: CN1.48 (VPA), U9.116
Z_MTCR: CN1.18 (XRDY/~MTCR), U6.17 (2B4)
Z_READ: CN1.68 (READ), U6.12 (1B8)
Z_SENSEZ3: CN1.91 (GND/SenseZ3), RN16.2, U9.118
Z_SLAVE: CN1.9 (~SLAVE), U9.121
