LIV2/A4092-dev/Kicad/A4092-backpanel.kicad_pcb

## KiCad design Kicad/A4092-backpanel.kicad_pcb (2025-04-26)

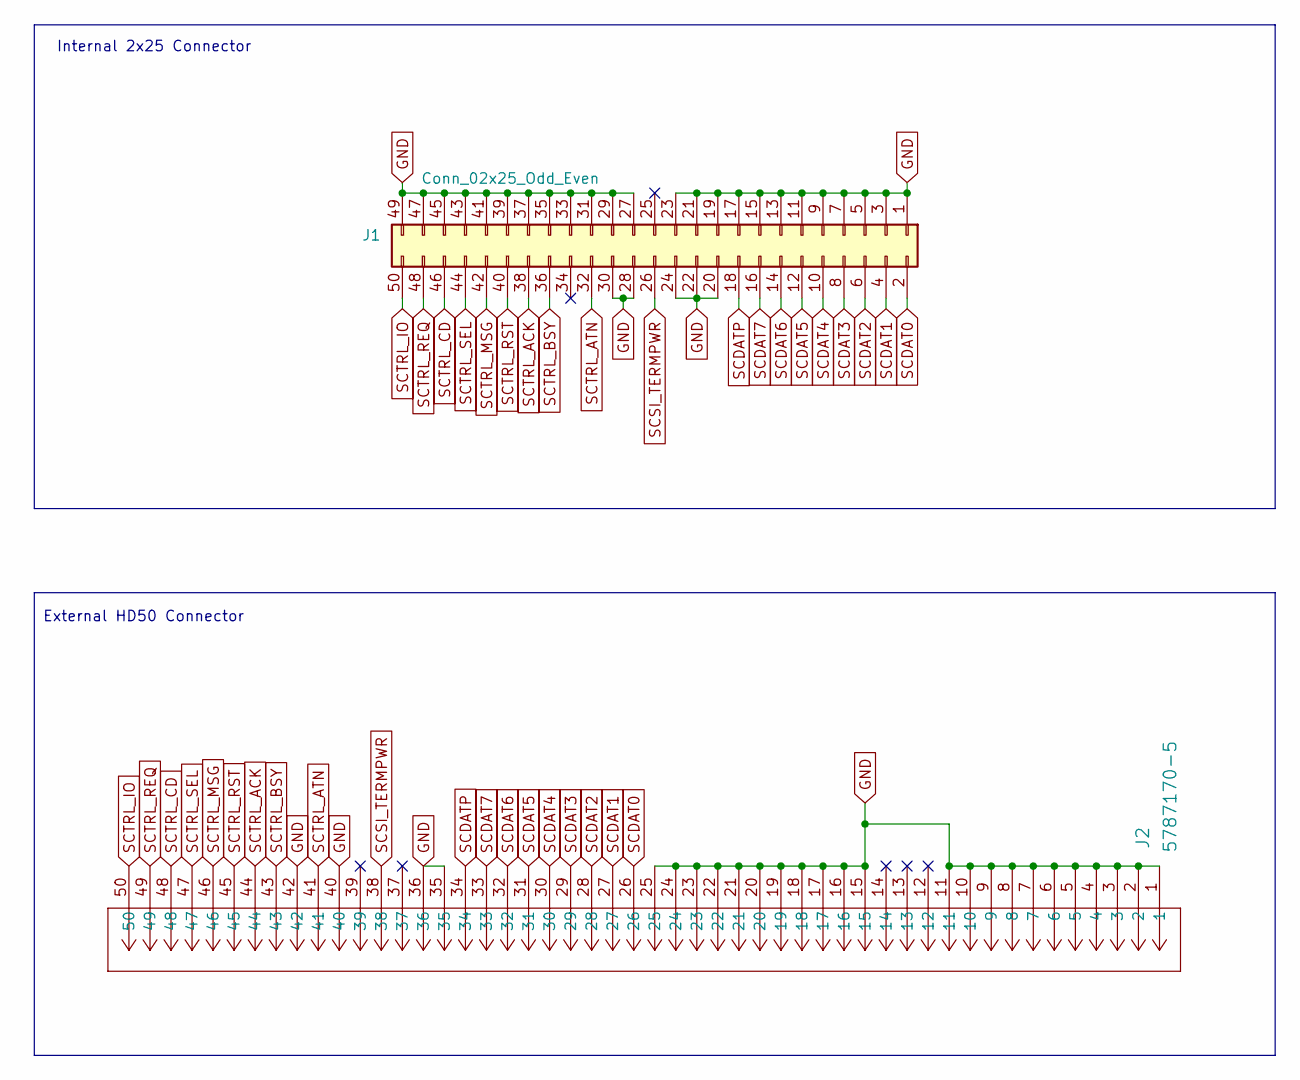
[picture p7: schematic A4092-backpanel.kicad_sch, A4092 backpanel PCB]

Parts:
J1: Conn_02x25_Odd_Even; IDC-Header_2x25_P2.54mm_Vertical
J2: 5787170-5; CONN_5787170-5_TYC

Connections:
GND: J1.1, J1.3, J1.5, J1.7, J1.9, J1.11, J1.13, J1.15, J1.17, J1.19, J1.20, J1.21, J1.22, J1.23, J1.24, J1.27, J1.28, J1.29, J1.30, J1.31, J1.33, J1.35, J1.37, J1.39, J1.41, J1.43, J1.45, J1.47, J1.49, J2.1, J2.2, J2.3, J2.4, J2.5, J2.6, J2.7, J2.8, J2.9, J2.10, J2.11, J2.15, J2.16, J2.17, J2.18, J2.19, J2.20, J2.21, J2.22, J2.23, J2.24, J2.25, J2.35, J2.36, J2.40, J2.42
SCDAT0: J1.2, J2.26
SCDAT1: J1.4, J2.27
SCDAT2: J1.6, J2.28
SCDAT3: J1.8, J2.29
SCDAT4: J1.10, J2.30
SCDAT5: J1.12, J2.31
SCDAT6: J1.14, J2.32
SCDAT7: J1.16, J2.33
SCDATP: J1.18, J2.34
SCSI_TERMPWR: J1.26, J2.38
SCTRL_ACK: J1.38, J2.44
SCTRL_ATN: J1.32, J2.41
SCTRL_BSY: J1.36, J2.43
SCTRL_CD: J1.46, J2.48
SCTRL_IO: J1.50, J2.50
SCTRL_MSG: J1.42, J2.46
SCTRL_REQ: J1.48, J2.49
SCTRL_RST: J1.40, J2.45
SCTRL_SEL: J1.44, J2.47

Notes on the sheet:
Internal 2x25 Connector
External HD50 Connector

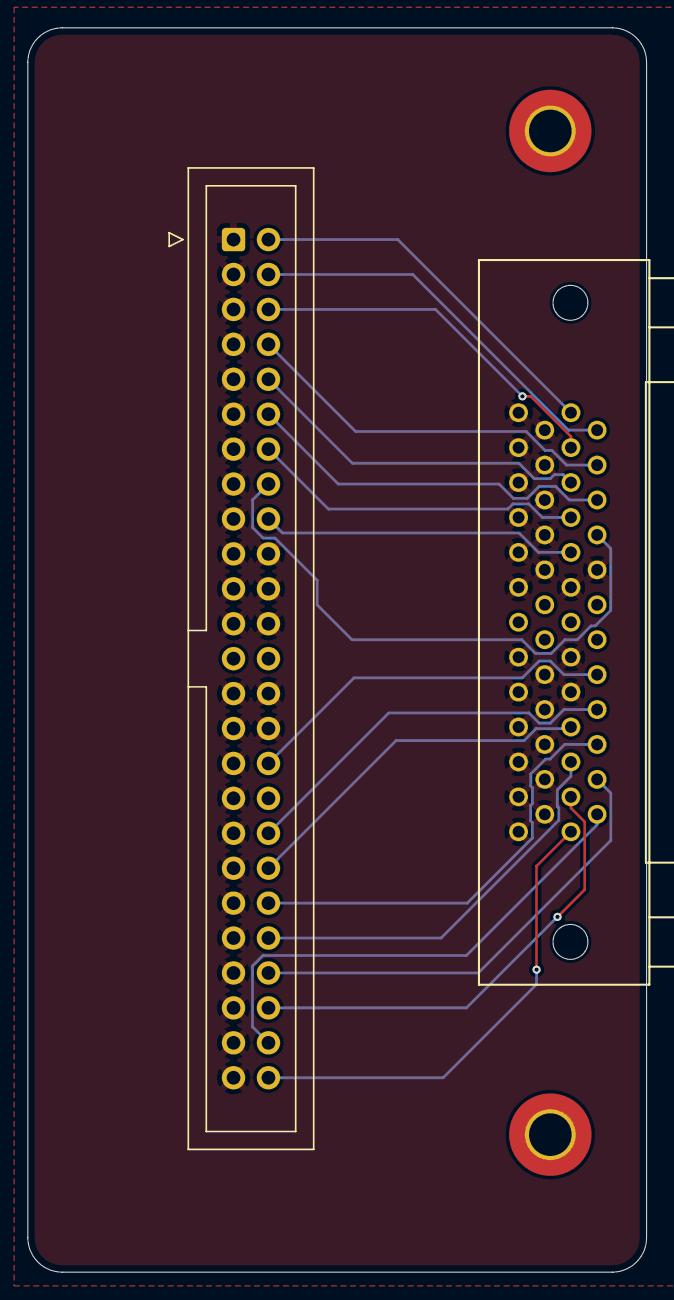
[picture p8: board A4092-backpanel.kicad_pcb from above]

Board: 2 copper layers, 45.0 x 90.5 mm, 4 parts (0 on the bottom side), 20 nets.

Other parts of the board:
H1, H2: MOUNT_HOLE; MOUNT_HOLE_M3
