LIV2/A4092-dev/(commit log)

2025-03-05 Empty KiCad project
    [A4092.kicad_pcb, A4092.kicad_sch]
2025-03-05 Add hierarchy
    [A4092.kicad_pcb, A4092.kicad_sch, Overview.kicad_sch, Termination.kicad_sch, power.kicad_sch, scsi2.kicad_sch, terminator.kicad_sch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]
2025-03-11 Start populating Zorro III
    [A4092.kicad_sch, zorro3.kicad_sch]
2025-03-12 Remove bak file and add footprint/symbol tables
2025-03-12 Place CPLD, NCR and last 543 (Latched Trabceiver)
    [scsi2.kicad_sch, zorro3.kicad_sch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]
2025-03-16 Update design
    [A4092.kicad_sch, Termination.kicad_sch, scsi2.kicad_sch, zorro3.kicad_sch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]
2025-03-23 Add external SCSI connector
2025-03-24 Redraw footprints, finish Termination/Connectors
    [A4092.kicad_sch, Termination.kicad_sch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]
2025-03-26 More work. Getting there.
    [Overview.kicad_sch, Termination.kicad_sch, power.kicad_sch, scsi2.kicad_sch, terminator.kicad_sch, zorro3.kicad_sch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]
2025-03-29 Update footprints
2025-03-29 Latest updates
    [Termination.kicad_sch, power.kicad_sch, scsi2.kicad_sch, zorro3.kicad_sch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]
2025-03-29 Add power connectors
2025-03-29 Finished first pass at new schematics
    [A4092.kicad_pcb, Termination.kicad_sch, power.kicad_sch]
2025-03-30 Update RN footprint to CAY16_102J4LF
    - Rename RNs from R to RN.
    - Fix U5 footprint
    - Rename pages to be consecutive numbers
    [A4092.kicad_pcb, A4092.kicad_sch, Termination.kicad_sch, scsi2.kicad_sch, zorro3.kicad_sch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]
2025-03-30 Connect VCCINT on CPLD, add GND and V5 to power symbols
    [A4092.kicad_pcb, power.kicad_sch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]
2025-03-30 Switch to 74ABT16543
    [zorro3.kicad_sch]
2025-03-30 Remove ABT TODO
    [zorro3.kicad_sch]
2025-03-30 Incorporate Feedback from LIV2
    - Move CLK, CLKI, Z_7M to GCLK1, GCLK2, GCLK3
    as they are connected to all macro cells.
    - OE1 and GCLR on the 1508 are input only, move FC0/FC1 there.
    Also found two duplicate signals on the ATF1508, consolidated them.
    This leaves us with 8 free I/Os at the moment.
    [A4092.kicad_pcb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]
2025-03-30 Add link to datasheet to cpld
    [cpld.kicad_sch]
2025-03-30 Drop 74ABT74
    The 74ABT74 is only used as a divider to create 25MHz from the 50MHz clock, and
    it can be removed. Instead, the 50MHz are directly brought to the ATF1508. CLK
    will be used as an output, not an input, so move away from GCLK pin. CLKI is no
    longer needed on a pin as it doesn't connect to anything anymore.
    [A4092.kicad_pcb, scsi2.kicad_sch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]
2025-03-30 Move IORST to Reset / GCLR Pin
    [A4092.kicad_pcb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]
2025-03-30 Free up some pins and add an LED
    [A4092.kicad_pcb, scsi2.kicad_sch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]
2025-04-01 Move to XC95144XL
    and other changes related to that.
    [A4092.kicad_pcb, scsi2.kicad_sch, zorro3.kicad_sch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]
2025-04-02 1. Placement looks feasible on 1 layer. Pending routing confirmation. 2. pages 1-2 placed. 3. components outside the outline are looking for a new home.
    [A4092.kicad_pcb]
2025-04-02 Reorg Kicad files to Kicad/
    [A4092.kicad_pcb, A4092.kicad_sch, Termination.kicad_sch, power.kicad_sch, scsi2.kicad_sch, zorro3.kicad_sch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]
2025-04-02 Add skeleton to include Gerbers, BOM files, RTL etc
2025-04-03 Rotaded J1 by 180 degree and re-arrange components close to the controller
    [A4092.kicad_pcb]
2025-04-10 Routed several nets
    [A4092.kicad_pcb]
2025-04-10 Start adding pin descriptions to A4092 RTL
2025-04-11 Routing in progress
    [A4092.kicad_pcb]
2025-04-11 CPLD bypass caps need to be on the 3.3V rail, not 5V
    [cpld.kicad_sch]
2025-04-11 Remove large Molex power connector
    [power.kicad_sch]
2025-04-11 Resync the PCB from Schematics, add some 3d models
    [A4092.kicad_pcb]
2025-04-11 Update Kicad project file
2025-04-12 Fixed SCSI connector footprint. Added 3d models for all parts.
    [A4092.kicad_pcb]
2025-04-12 Fix Xilinx 3d model in footprint
    [A4092.kicad_pcb]
2025-04-12 Fix HS_GND connection on pin2 of the scsi terminators
    [Termination.kicad_sch]
2025-04-13 SW1 and U10 breakout
    [A4092.kicad_pcb]
2025-04-15 Fix 74FCT16543 and CAY16_102J4LF footprints
    [A4092.kicad_pcb]
2025-04-16 SCSI Controller breakout
    [A4092.kicad_pcb]
2025-04-18 CPLD fixes
    * Terminate unused CPLD connections with NC
    * Move D0 to pin 117 to line up with the other databus pins
    [A4092.kicad_pcb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]
2025-04-18 Rename all Uxx parts from U1 to U13 for consistency
    [A4092.kicad_pcb, Termination.kicad_sch, scsi2.kicad_sch, zorro3.kicad_sch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]
2025-04-19 Fix up some silkscreen
    [A4092.kicad_pcb]
2025-04-19 Undo silkscreen changes
    [A4092.kicad_pcb]
2025-04-19 Move D0/D1 (again) and remove PLD_INT
    [cpld.kicad_sch]
2025-04-19 routing progress
    [A4092_0418.kicad_pcb]
2025-04-19 Import netlist from commit: Move D0/D1 (again) and remove PLD_INT
    [A4092.kicad_pcb]
2025-04-19 Clean up CPLD signals / prepare for rotation
    [cpld.kicad_sch]
2025-04-20 Update Flash part symbol
    [scsi2.kicad_sch]
2025-04-20 Fix Zorro III symbol
    [zorro3.kicad_sch]
2025-04-20 ROM_WE Single net Issue #3
    Connect ROM_WE to CPLD. Also connect ROM_CE.
    [A4092.kicad_pcb, scsi2.kicad_sch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]
2025-04-20 Fix Z_LOCK in zorro3 schematics
    [zorro3.kicad_sch]
2025-04-20 CPLD Routing
    [A4092_0419.kicad_pcb]
2025-04-20 Your commit message
    [A4092.kicad_pcb, A4092_0419.kicad_pcb]
2025-04-20 PLD_NACK is only a CPLD internal signal
    [cpld.kicad_sch]
2025-04-20 This should be PLD_DS0, not PLD_DS1
    [zorro3.kicad_sch]
2025-04-20 CPLD pin net swap (issue #7)
    • PLD_FC0-FC2 nets move from Pin 2-4 to 75-77
    • PLD_DS0-DS2 nets move from Pin 33-35 to 78-80
    • ROM_WE net move from Pin 102 to 5
    • ROM_OE net move from Pin 107 to 4
    Additionally moved ROM_CE to P3 and PLD_DS3 to P81
    [cpld.kicad_sch]
2025-04-20 Update PCB from schematics
    [A4092.kicad_pcb]
2025-04-20 Add Kicad/A4092.kicad_prl to .gitignore
2025-04-20 Fix various errors from issue #1
    [power.kicad_sch, scsi2.kicad_sch, zorro3.kicad_sch]
2025-04-20 routin gin progress
    [A4092.kicad_pcb]
2025-04-20 Update sheet, add pull down on ROM_CE
    [A4092.kicad_sch, Termination.kicad_sch, power.kicad_sch, scsi2.kicad_sch, zorro3.kicad_sch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]
2025-04-20 Update from schematics
    [A4092.kicad_pcb]
2025-04-20 Stop tracking A4092.kicad_prl
2025-04-20 Add footprint to pull down of ROM_CE
    [scsi2.kicad_sch]
2025-04-20 Add pulldown of ROM_CE to PCB
    [A4092.kicad_pcb]
2025-04-22 Move transceivers north
    [A4092.kicad_pcb]
2025-04-22 more routing
    [A4092.kicad_pcb]
2025-04-23 Fix issues #12 and #13
    Z_BEER and SCSI_BUSY were not connected correctly (single net pins)
    [A4092.kicad_pcb, Termination.kicad_sch, zorro3.kicad_sch]
2025-04-24 Feedback impleted for: [200~SCSI_TERMPWR traces should be 0.3mm min~
    [A4092.kicad_pcb]
2025-04-24 Feedback implemented:Make sure card guides don't hit components on the left side
    [A4092.kicad_pcb]
2025-04-26 Move HPDB50 connector to back panel
    [A4092-backpanel.kicad_pcb, A4092-backpanel.kicad_sch, A4092.kicad_pcb, Termination.kicad_sch]
2025-04-27 Routing and J5 placement
    [A4092.kicad_pcb]
2025-04-29 General routing
    [A4092.kicad_pcb]
2025-05-03 Rename majority of bypass capacitors to match their Uxx
    i.e. U4 will have C4A, C4B, C4C, C4D
    [A4092.kicad_pcb, power.kicad_sch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]
2025-05-03 Revert: Rename majority of bypass capacitors to match their Uxx
    [A4092.kicad_pcb, power.kicad_sch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]
2025-05-05 Replace C47 and C46 with Tantalum capacitors
    [A4092.kicad_pcb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]
2025-05-05 Add more bypass caps
    [A4092.kicad_pcb, power.kicad_sch]
2025-05-05 Rename capacitors
    [A4092.kicad_pcb, Termination.kicad_sch, power.kicad_sch, scsi2.kicad_sch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]
2025-05-06 Fix up silkscreen across the board
    [A4092.kicad_pcb]
2025-05-07 Add clocks, replace 74F74
    [top.v]
2025-05-07 Fix up molex connector
    [A4092.kicad_pcb]
2025-05-07 Fix pin mapping
2025-05-09 Update termination capacitors to tantalum
    and clean up bypass caps in schematic
    [A4092.kicad_pcb, Termination.kicad_sch, power.kicad_sch]
2025-05-09 Add two missing bulk power caps from old schematics
    [A4092.kicad_pcb, power.kicad_sch]
2025-05-12 Try to fix up pin naming
    [A4092.ucf, buffer_control.v, top.v]
2025-05-12 Add 3d model to power connector
    It somehow got lost along the way
    [A4092.kicad_pcb]
2025-05-12 Connect SC0 from 53c710 to CPLD
    This will let us implement the "False DMA Request Bugfix"
    [A4092.kicad_pcb, scsi2.kicad_sch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]
2025-05-15 HD50 conn routing
    [A4092.kicad_pcb]
2025-05-15 Kicad: Pin swaps on RN10 and RN16
    Fixes issue #1 and issue #2
    [A4092.kicad_pcb, scsi2.kicad_sch, zorro3.kicad_sch]
2025-05-16 SW1 routing
    [A4092.kicad_pcb]
2025-05-17 Signal routing
    [A4092.kicad_pcb]
2025-05-17 DRCs checks
    [A4092.kicad_pcb]
2025-05-17 bypass caps routing
    [A4092.kicad_pcb]
2025-05-18 V3_3 routing
    [A4092.kicad_pcb]
2025-05-18 PWR routing
    [A4092.kicad_pcb]
2025-05-18 Remove a rogue NC
    [scsi2.kicad_sch]
2025-05-18 Connect DIP_EXT_TERM to CPLD
    [Termination.kicad_sch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]
2025-05-19 Add correct footprints for DIP resistors
    And start adding LCSC part numbers
    [A4092.kicad_pcb, Termination.kicad_sch]
2025-05-19 GND connections
    [A4092.kicad_pcb]
2025-05-20 Add more LCSC parts and mark some parts DNP
    [Termination.kicad_sch, power.kicad_sch, scsi2.kicad_sch, zorro3.kicad_sch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]
2025-05-20 Update PCB from schematic
    [A4092.kicad_pcb]
2025-05-20 RN15 pin swap
    As requested in issue #7
    [Termination.kicad_sch, zorro3.kicad_sch]
2025-05-20 Pin swap on RN15 the right way
    [zorro3.kicad_sch]
2025-05-20 Update PCB from schematic, routing
    [A4092.kicad_pcb]
2025-05-20 Add remaining part numbers, remove C20, C30, C31
    [A4092.kicad_pcb, power.kicad_sch, scsi2.kicad_sch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]
2025-05-21 Fix LCSC parts issues
    [power.kicad_sch, scsi2.kicad_sch, zorro3.kicad_sch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]
2025-05-21 Update PCB file
    [A4092.kicad_pcb]
2025-05-21 Use APAQ Tech 250AVHA470M0606 not AVEA
    [A4092.kicad_pcb, power.kicad_sch]
2025-05-21 Update SCSI connector
    [A4092.kicad_pcb, Termination.kicad_sch]
2025-05-22 V5 Routing
    [A4092.kicad_pcb]
2025-05-23 Improve Zorro III connector and round off PCB outline
    [A4092.kicad_pcb]
2025-05-23 Update footprint graphics
    Unify using a dot rather than asterisk for pin 1
    Remove pin 1 designator for ferrites
2025-05-23 Clean up schematics
    [power.kicad_sch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]
2025-05-24 Minor trace and silkscreen fixes
    [A4092.kicad_pcb]
2025-05-26 Add fiducials and clean up schematics
    [Termination.kicad_sch, power.kicad_sch, scsi2.kicad_sch, zorro3.kicad_sch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]
2025-05-26 Update PCB image
2025-05-27 GND vias
2025-05-27 Add SPI flash option and move flash to its own page
    [flash.kicad_sch, scsi2.kicad_sch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]
2025-05-27 Hook up Flash page
    [A4092.kicad_sch]
2025-05-27 Recreate PCB from schematics
    Changed footprints to sync cleanly on the Mac
    [flash.kicad_sch]
2025-05-28 Add D[12..15] and A[9..16,20] to CPLD
    [cpld.kicad_sch]
2025-05-28 Re-sort address lines
    [cpld.kicad_sch]
2025-05-28 Fix 3V3 -> V3_3
    [flash.kicad_sch]
2025-05-28 Review fixes on scsi2 page
    * R11 is 22 Ohm not 120 in the original schematics
    * FETCH# is NC in the original, not V5
    [scsi2.kicad_sch]
2025-05-28 Add bypass cap for Berg connector
    [power.kicad_sch]
2025-05-28 Add Zorro 3 DMA master
2025-05-29 board cleanup
2025-05-29 Restructure directories, Add Terminator designs
    [A4092-backpanel.kicad_pcb, A4092-backpanel.kicad_sch, A4092-terminator-dev.kicad_pcb, A4092-terminator-dev.kicad_sch, A4092-terminator-ds2107.kicad_pcb, A4092-terminator-ds2107.kicad_sch, A4092-terminator.kicad_pcb, A4092-terminator.kicad_sch]
2025-05-29 Move A4092 main PCB to subdirectory
    - Move current main design to A4092
    - Add fp-lib-table and sym-lib-table with correct paths to
    each sub directory
    [A4092.kicad_sch, Termination.kicad_sch, flash.kicad_sch, power.kicad_sch, scsi2.kicad_sch, zorro3.kicad_sch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]
2025-05-30 RTL: Add additional data and address lines
    and fix address map
    [A4092.ucf, buffer_control.v, rom_access.v, scsi_access.v, sid_access.v]
2025-05-30 RTL: Add additional address, data and spi signals
2025-06-01 Fix 3d image path in footprints
2025-06-01 Update JLCPCB part numbers
    Move to available and, if possible, basic parts
    [Termination.kicad_sch, flash.kicad_sch, scsi2.kicad_sch]
2025-06-05 Fix Data Bus output
    [top.v]
2025-06-06 Update PCB from Schematics, new image
2025-06-06 Add SN74ABT16543DGGR symbol / footprint
2025-06-06 Update to use new footprint for U1,2,3,4
    [zorro3.kicad_sch]
2025-06-06 Update PCB
2025-06-07 Add Gerbers
    [bom.csv, designators.csv, positions.csv]
2025-06-07 RTL: Fix signal naming and hook up right bits of DIP
    [A4092.ucf, sid_access.v, top.v]
2025-06-08 Update LT1118-2.85 based terminator
    [A4092-terminator.kicad_pcb, A4092-terminator.kicad_sch]
2025-06-09 Update DEV version of the terminator
    with switch for experimenting w/ mosfet
    [A4092-terminator-dev.kicad_pcb, A4092-terminator-dev.kicad_sch]
2025-06-09 Finish DS2107 terminator
    [A4092-terminator-dev.kicad_pcb, A4092-terminator-ds2107.kicad_pcb, A4092-terminator-ds2107.kicad_sch]
2025-06-09 Fix up capacitor array footprint
    家裡創 did not like the digikey footprint.
    [Termination.kicad_sch]
2025-06-09 Add rotations for all parts
    [Termination.kicad_sch, flash.kicad_sch, power.kicad_sch, scsi2.kicad_sch, zorro3.kicad_sch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]
2025-06-10 Update Backpanel for smaller footprint
    [A4092-backpanel.kicad_pcb]
2025-06-13 Allow bridged solder mask for Zorro3 connector
2025-06-13 Remove spaces from JLCPCB part numbers
    [Termination.kicad_sch, flash.kicad_sch]
2025-06-30 buffer_control: Plumb through all buffer enables
    When an input pin on a BiCMOS logic chip like the SN74ABT543 is left floating
    (unconnected), its voltage can drift into an indeterminate state, somewhere
    between a valid logic HIGH and a valid logic LOW.
    In this intermediate state, both the internal pull-up and pull-down transistors
    inside the chip's input buffer can turn on simultaneously. This creates a
    low-impedance path directly from the power supply (Vcc) to ground (GND). This
    condition is known as shoot-through current, and it causes the chip to draw
    excessive power, which is dissipated as heat. This can make the chip get hot
    very quickly and can permanently damage it.
    [buffer_control.v, top.v]
2025-07-01 Move memory map handling into top.v
    - Rename Z_7M to C7M
    - Rename MYBBUS to MYBUS_n as it is active low
    - Don't pass ADDR[] into modules if not needed
    (intreg still missing)
    - Fix SBG_n in zorro arbiter
    [A4092.ucf, buffer_control.v, rom_access.v, scsi_access.v, sid_access.v, top.v, zorro_master_arbiter.v]
2025-07-01 Fix RCHNG in zorro arbiter
    and add dummy spi module
    [sid_access.v, spi_access.v, top.v, zorro_master_arbiter.v]
2025-07-02 factor out scsi slave module
    - stub out spi module
    - top: A[] is now inout
    - top: CLK and MASTER_n are wires
    - top: SIZ is an output to the SCSI chip
    - straighten zorro arbiter
2025-07-02 Fix signal names for scsi slave interface
    [top.v]
2025-07-10 a4092flash: Fix detection and verification
    [main.c]
2025-07-12 Fix verification code in a4092flash
    [main.c]
2025-07-13 Fixup DOE
    It must be an inout not an output
    Also add a synchronizer for DOE and DS
    [top.v]
2025-07-13 Fixup address decodes
    *_region was matching when slave_cycle was true but without checking that the base address matched - this would cause these regions to match when other Z3 boards are being accessed
    [top.v]
